0xADE1A1DE/USB-Injection/FS Keystroke Injector/sources_1/ip/clk_wiz_0/clk_wiz_0_stub.v

// Copyright 1986-2020 Xilinx, Inc. All Rights Reserved.
// --------------------------------------------------------------------------------
// Tool Version: Vivado v.2020.1 (win64) Build 2902540 Wed May 27 19:54:49 MDT 2020
// Date        : Wed Jan 12 16:14:25 2022
// Host        : Robs-PC running 64-bit major release  (build 9200)
// Command     : write_verilog -force -mode synth_stub -rename_top clk_wiz_0 -prefix
//               clk_wiz_0_ clk_wiz_0_stub.v
// Design      : clk_wiz_0
// Purpose     : Stub declaration of top-level module interface
// Device      : xc7k325tffg900-2
// --------------------------------------------------------------------------------

// This empty module with port declaration file causes synthesis tools to infer a black box for IP.
// The synthesis directives are for Synopsys Synplify support to prevent IO buffer insertion.
// Please paste the declaration into a Verilog source file or add the file as an additional source.
module clk_wiz_0(clk_out1, clk_in1_p, clk_in1_n)
/* synthesis syn_black_box black_box_pad_pin="clk_out1,clk_in1_p,clk_in1_n" */;
  output clk_out1;
  input clk_in1_p;
  input clk_in1_n;
endmodule
