0xADE1A1DE/USB-Injection/FS Keystroke Injector/sources_1/ip/clk_wiz_0/clk_wiz_0_stub.vhdl

-- Copyright 1986-2020 Xilinx, Inc. All Rights Reserved.
-- --------------------------------------------------------------------------------
-- Tool Version: Vivado v.2020.1 (win64) Build 2902540 Wed May 27 19:54:49 MDT 2020
-- Date        : Wed Jan 12 16:14:25 2022
-- Host        : Robs-PC running 64-bit major release  (build 9200)
-- Command     : write_vhdl -force -mode synth_stub -rename_top clk_wiz_0 -prefix
--               clk_wiz_0_ clk_wiz_0_stub.vhdl
-- Design      : clk_wiz_0
-- Purpose     : Stub declaration of top-level module interface
-- Device      : xc7k325tffg900-2
-- --------------------------------------------------------------------------------
library IEEE;
use IEEE.STD_LOGIC_1164.ALL;

entity clk_wiz_0 is
  Port ( 
    clk_out1 : out STD_LOGIC;
    clk_in1_p : in STD_LOGIC;
    clk_in1_n : in STD_LOGIC
  );

end clk_wiz_0;

architecture stub of clk_wiz_0 is
attribute syn_black_box : boolean;
attribute black_box_pad_pin : string;
attribute syn_black_box of stub : architecture is true;
attribute black_box_pad_pin of stub : architecture is "clk_out1,clk_in1_p,clk_in1_n";
begin
end;
